aig-microC/Caldera-email/assets/ESP32_enCI.jpg

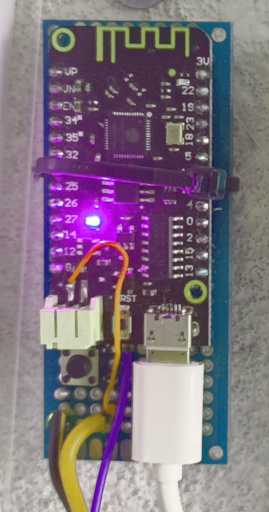
assets/ESP32_enCI.jpg
