aig-microC/Caldera-email/assets/ESP32_Relé.jpg

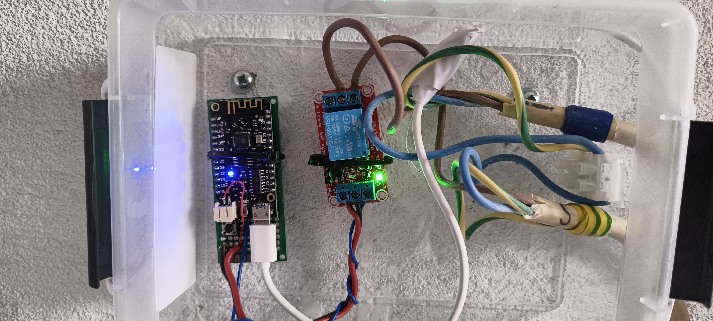
assets/ESP32_Relé.jpg
