aig-microC/Caldera-email/assets/Relé.jpg

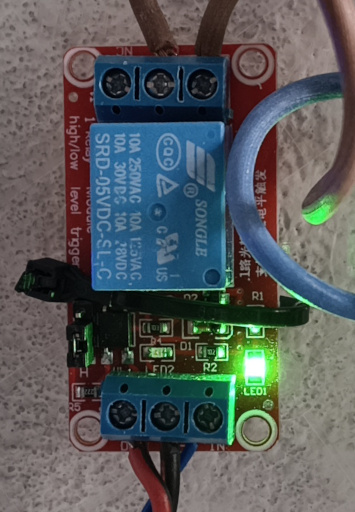
assets/Relé.jpg
